wavtrontec/Wavtron-Tinker5/hardware/Tinker5_Schematic.pdf

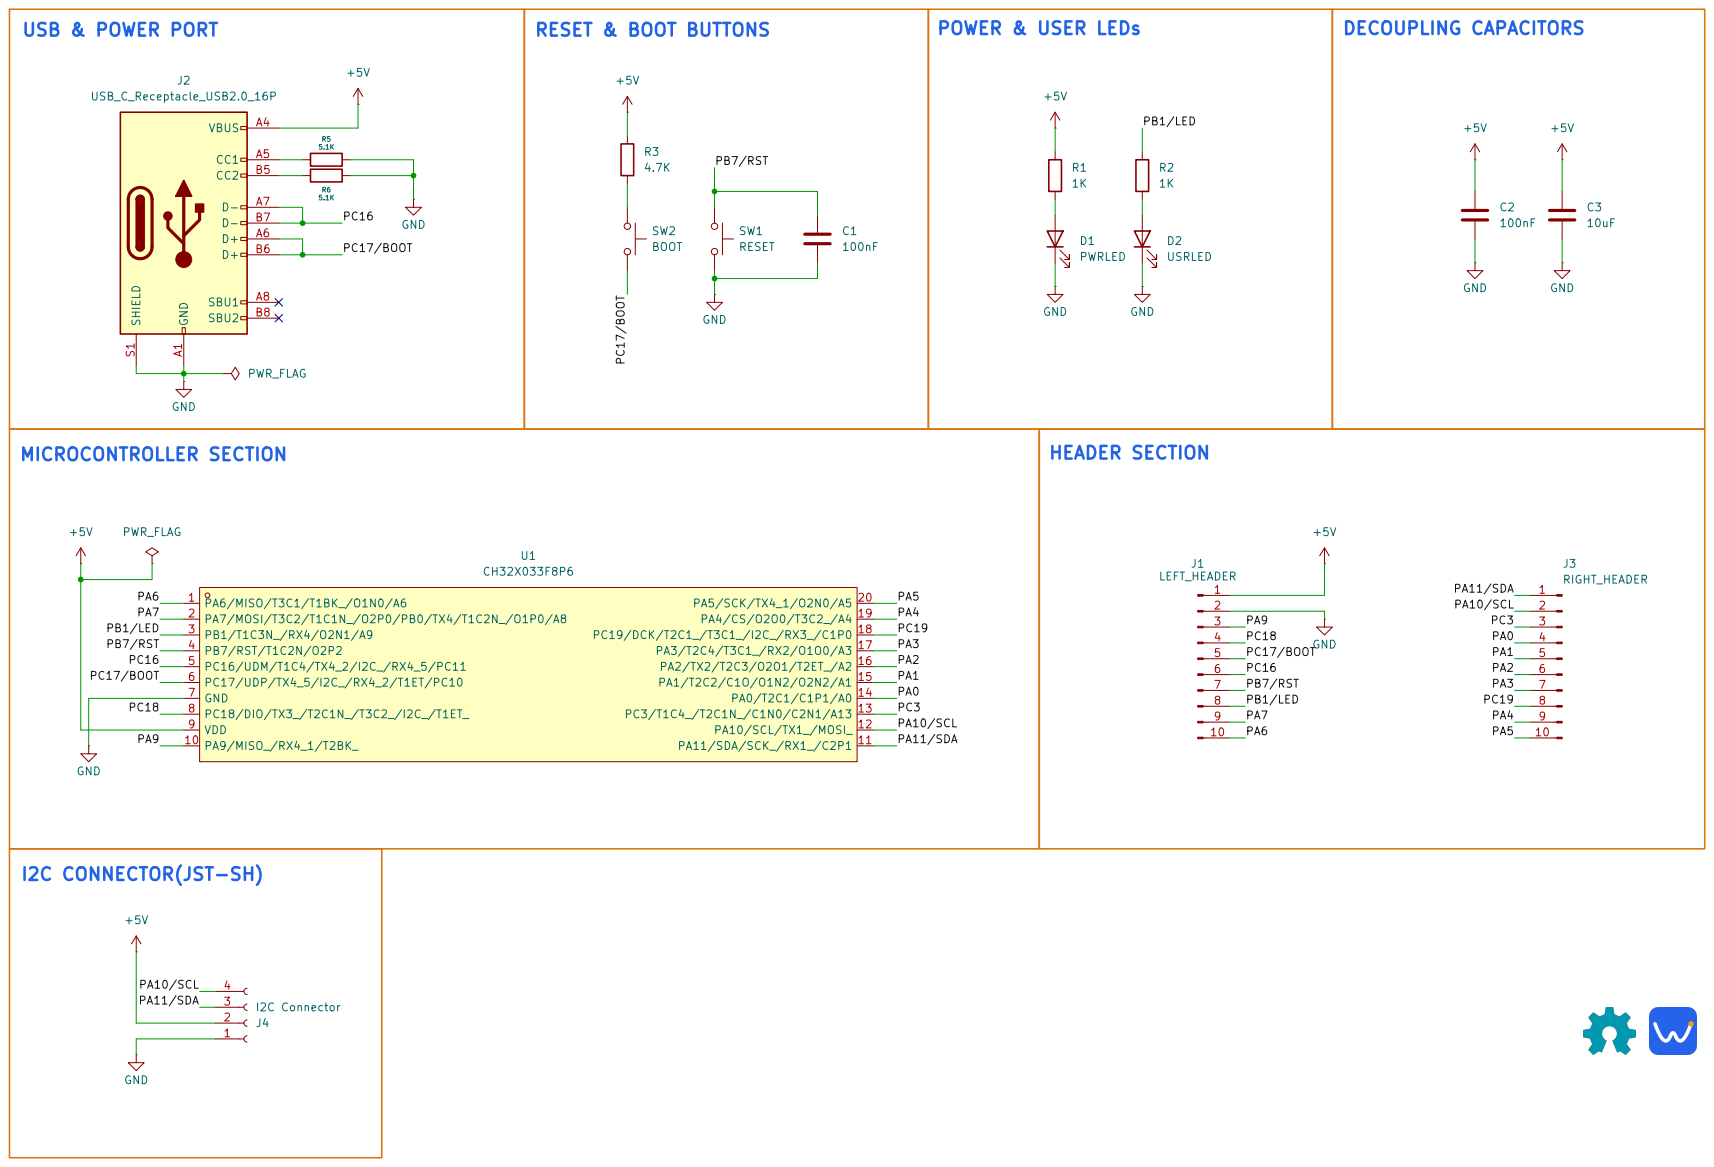
[picture p2: page 1]
